yswallow/kidoairaku-swallowtail/assembly/kidoairaku-swallowtail-bom.csv

Designator | MPN | Qty | Link
D193,D206,D148,D155,D102,D251,D207,D188,D137,D149,D229,D104,D197,D196,D150,D153,D175,D120,D165,D240,D258,D228,D221,D220,D135,D145, D257,D158,D186,D112,D224,D237,D248,D231,D154,D164,D129,D210,D130,D254,D167,D126,D177,D195,D117,D199,D185,D255,D203,D171,D191,D121,D178, D162,D260,D140,D151,D204,D122,D134,D113,D249,D156,D245,D239,D230,D172,D179,D108,D173,D128,D253,D211,D132,D250,D190,D252,D198,D143,D213, D232,D222,D99,D139,D142,D182,D205,D114,D174,D136,D223,D159,D181,D168,D200,D227,D116,D110,D189,D244,D105,D187,D236,D226,D217,D209,D138, D111,D202,D163,D144,D214,D234,D157,D242,D233,D109,D212,D184,D166,D152,D256,D238,D146,D161,D247,D147,D180,D194,D103,D125,D192,D201,D118, D123,D119,D259,D219,D127,D243,D246,D160,D218,D183,D169,D133,D170,D215,D235,D176,D225,D106,D131,D97,D107,D241,D141,D124,D101,D115,D208, D216 | SK6803MINI-E | 162 | https://www.aliexpress.com/item/1005003636607308.html
D21,D71,D37,D24,D63,D83,D17,D68,D34,D6,D46,D48,D41,D14,D13,D5,D57,D72,D86,D18,D75,D78,D98,D73,D87,D74,D54,D51,D62,D65,D58,D31,D4,D61, D53,D67,D3,D12,D76,D42,D28,D47,D64,D36,D2,D45,D84,D82,D32,D35,D7,D23,D38,D52,D26,D25,D16,D56,D15,D43,D8,D1,D27 | 1N4148W | 63
U1 | Seeed Studio XIAO RP2040 | 1 | 102010428
