yswallow/kidoairaku-swallowtail/assembly/kidoairaku-swallowtail-additional-doc/component-align.jpg

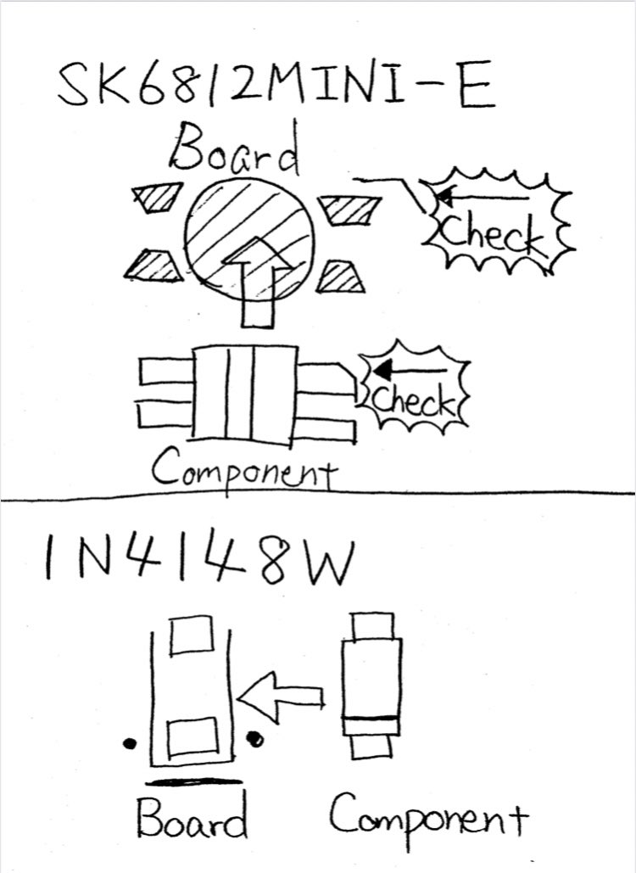
assembly/kidoairaku-swallowtail-additional-doc/component-align.jpg
