yswallow/kidoairaku-swallowtail/assembly/kidoairaku-swallowtail-additional-doc/kidoairaku-swallowtail-B_Fab.pdf

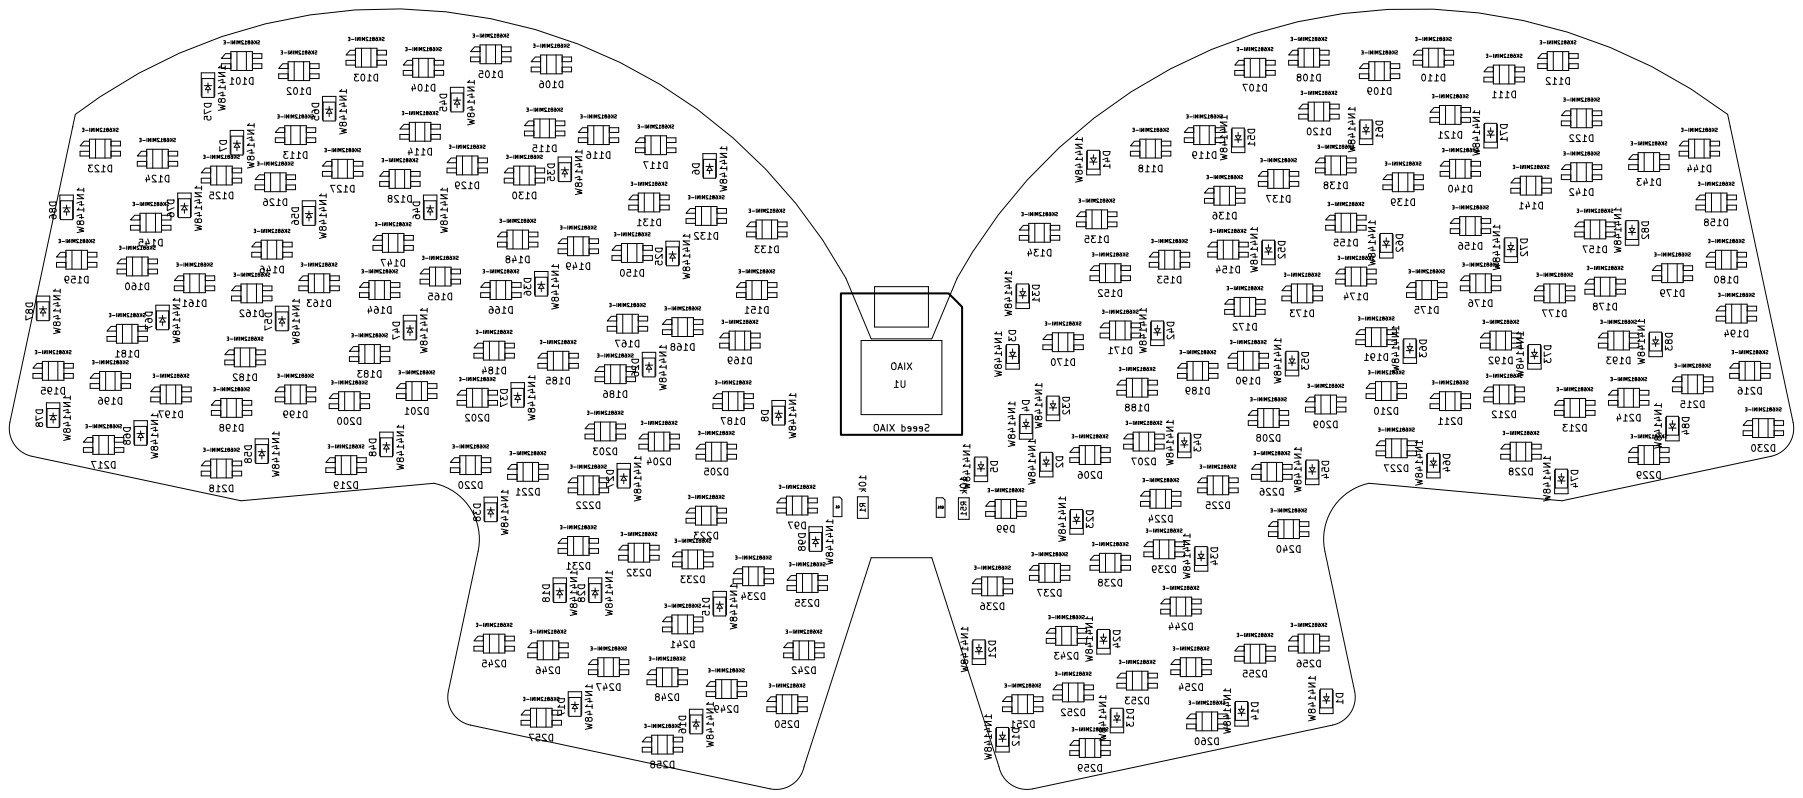
[picture p2: page 1]
