yswallow/kidoairaku-swallowtail/kidoairaku-swallowtail.kicad_pcb

## KiCad design kidoairaku-swallowtail.kicad_pcb (2023-01-27)

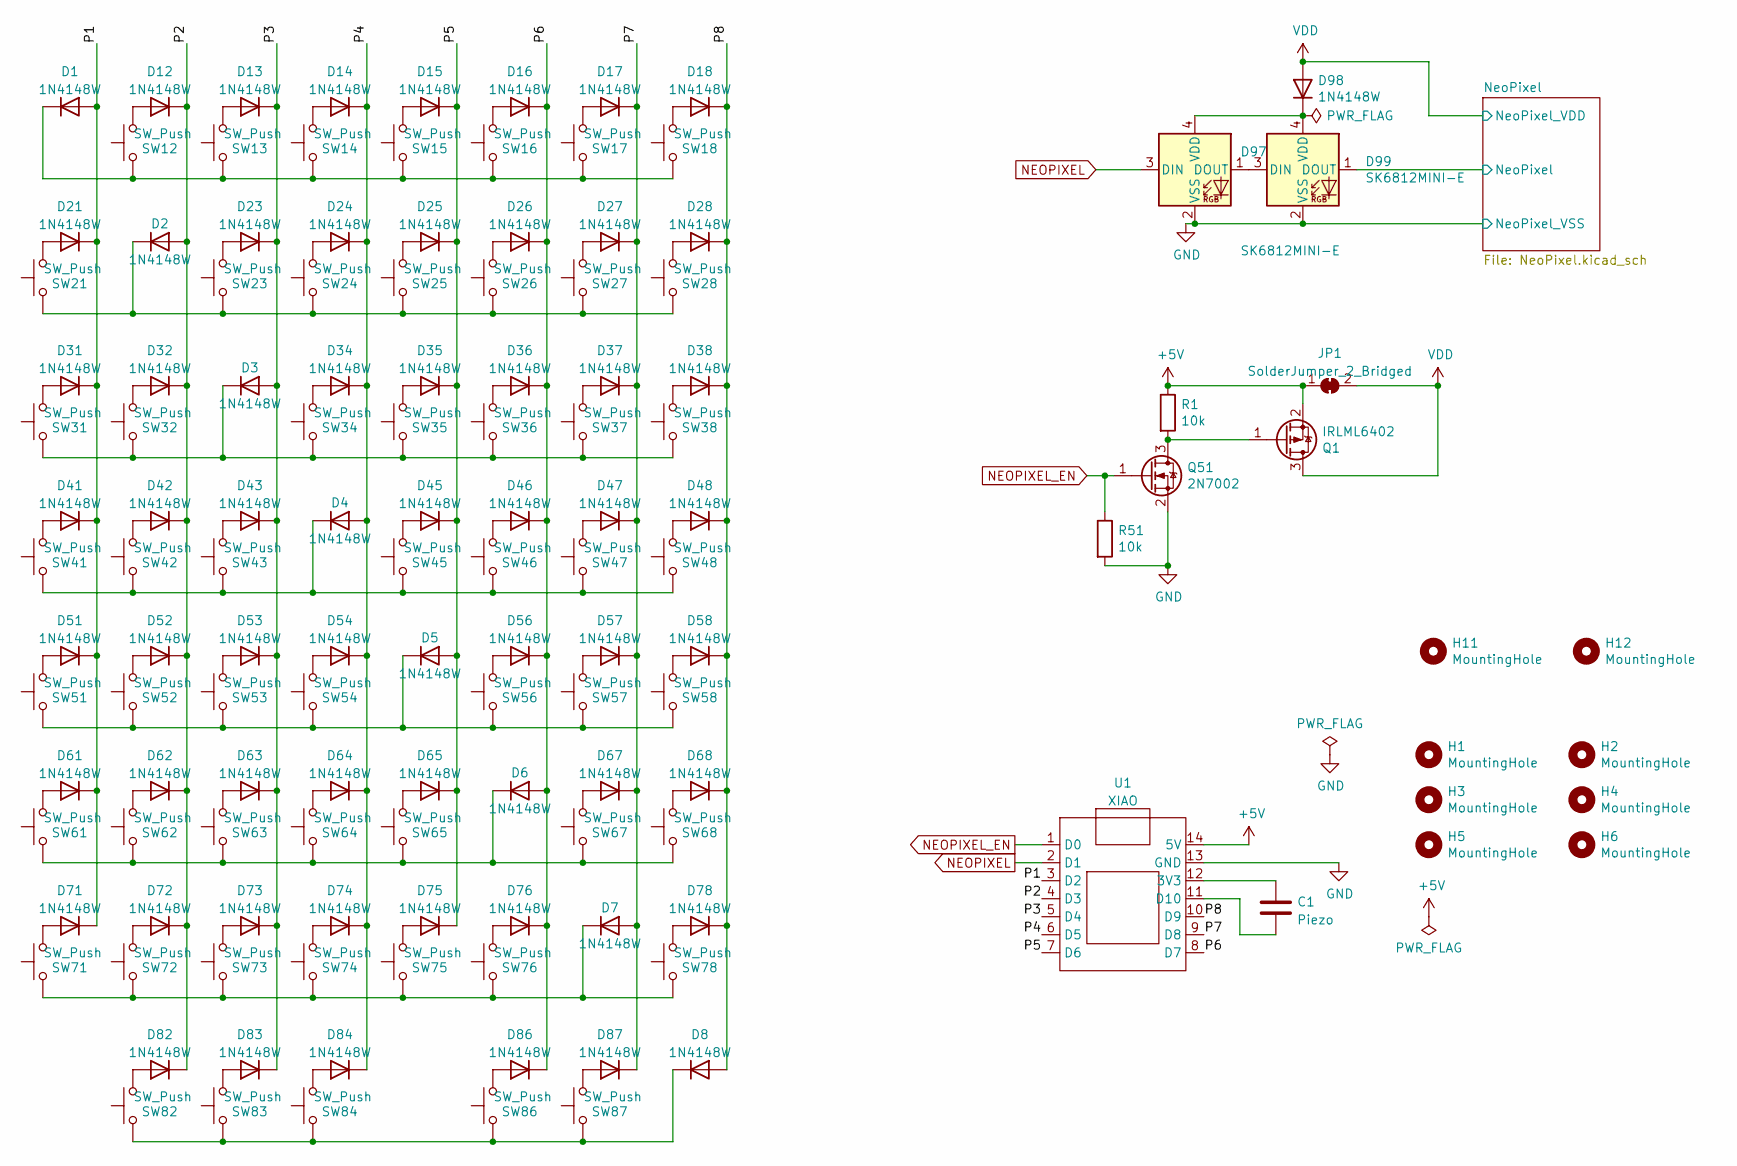
[picture p3: schematic kidoairaku-swallowtail.kicad_sch]

Parts:
C1: Piezo; C_Radial_D10.0mm_H12.5mm_P5.00mm
D1, D2, D3, D4, D5, D6, D7, D8, D12, D13, D14, D15, D16, D17, D18, D21, D23, D24, D25, D26, D27, D28, D31, D32, D34, D35, D36, D37, D38, D41, D42, D43, D45, D46, D47, D48, D51, D52, D53, D54, D56, D57, D58, D61, D62, D63, D64, D65, D67, D68, D71, D72, D73, D74, D75, D76, D78, D82, D83, D84, D86, D87, D98: 1N4148W; D_SOD-123
D97, D99: SK6812MINI-E; SK6812MINI-E_NoSilk-dril-PCBA
H1, H2, H3, H4, H5, H6, H11, H12: MountingHole; MountingHole_2.2mm_M2
JP1: SolderJumper_2_Bridged; SolderJumper-2_P1.3mm_Bridged_RoundedPad1.0x1.5mm
Q1: IRLML6402; SOT-23
Q51: 2N7002; SOT-23
R1, R51: 10k; R_1206_3216Metric_Pad1.30x1.75mm_HandSolder
SW12, SW13, SW14, SW15, SW16, SW17, SW18, SW21, SW23, SW24, SW25, SW26, SW27, SW28, SW31, SW32, SW34, SW35, SW36, SW37, SW38, SW41, SW42, SW43, SW45, SW46, SW47, SW48, SW51, SW52, SW53, SW54, SW56, SW57, SW58, SW61, SW62, SW63, SW64, SW65, SW67, SW68, SW71, SW72, SW73, SW74, SW75, SW76, SW78, SW82, SW83, SW84, SW86, SW87: SW_Push; SW_Choc_1U
U1: XIAO; Seeed XIAO SMD

Connections:
+5V: JP1.1 (A), Q1.2 (S), R1.1, U1.14 (5V)
/NeoPixel/NeoPixel: D99.1 (DOUT); also elsewhere on the board
/P1: D1.2 (A), D21.1 (K), D31.1 (K), D41.1 (K), D51.1 (K), D61.1 (K), D71.1 (K), U1.3 (D2)
/P2: D2.2 (A), D12.1 (K), D32.1 (K), D42.1 (K), D52.1 (K), D62.1 (K), D72.1 (K), D82.1 (K), U1.4 (D3)
/P3: D3.2 (A), D13.1 (K), D23.1 (K), D43.1 (K), D53.1 (K), D63.1 (K), D73.1 (K), D83.1 (K), U1.5 (D4)
/P4: D4.2 (A), D14.1 (K), D24.1 (K), D34.1 (K), D54.1 (K), D64.1 (K), D74.1 (K), D84.1 (K), U1.6 (D5)
/P5: D5.2 (A), D15.1 (K), D25.1 (K), D35.1 (K), D45.1 (K), D65.1 (K), D75.1 (K), U1.7 (D6)
/P6: D6.2 (A), D16.1 (K), D26.1 (K), D36.1 (K), D46.1 (K), D56.1 (K), D76.1 (K), D86.1 (K), U1.8 (D7)
/P7: D7.2 (A), D17.1 (K), D27.1 (K), D37.1 (K), D47.1 (K), D57.1 (K), D67.1 (K), D87.1 (K), U1.9 (D8)
/P8: D8.2 (A), D18.1 (K), D28.1 (K), D38.1 (K), D48.1 (K), D58.1 (K), D68.1 (K), D78.1 (K), U1.10 (D9)
GND: D97.2 (VSS), D99.2 (VSS), Q51.2 (S), R51.2, U1.13 (GND); also elsewhere on the board
NEOPIXEL: D97.3 (DIN), U1.2 (D1)
NEOPIXEL_EN: Q51.1 (G), R51.1, U1.1 (D0)
unnamed: D1.1 (K), SW12.2, SW13.2, SW14.2, SW15.2, SW16.2, SW17.2, SW18.2
unnamed: D2.1 (K), SW21.2, SW23.2, SW24.2, SW25.2, SW26.2, SW27.2, SW28.2
unnamed: D3.1 (K), SW31.2, SW32.2, SW34.2, SW35.2, SW36.2, SW37.2, SW38.2
unnamed: D4.1 (K), SW41.2, SW42.2, SW43.2, SW45.2, SW46.2, SW47.2, SW48.2
unnamed: D5.1 (K), SW51.2, SW52.2, SW53.2, SW54.2, SW56.2, SW57.2, SW58.2
unnamed: D6.1 (K), SW61.2, SW62.2, SW63.2, SW64.2, SW65.2, SW67.2, SW68.2
unnamed: D7.1 (K), SW71.2, SW72.2, SW73.2, SW74.2, SW75.2, SW76.2, SW78.2
unnamed: D8.1 (K), SW82.2, SW83.2, SW84.2, SW86.2, SW87.2
unnamed: D12.2 (A), SW12.1
unnamed: D13.2 (A), SW13.1
unnamed: D14.2 (A), SW14.1
unnamed: D15.2 (A), SW15.1
unnamed: D16.2 (A), SW16.1
unnamed: D17.2 (A), SW17.1
unnamed: D18.2 (A), SW18.1
unnamed: D21.2 (A), SW21.1
unnamed: D23.2 (A), SW23.1
unnamed: D24.2 (A), SW24.1
unnamed: D25.2 (A), SW25.1
unnamed: D26.2 (A), SW26.1
unnamed: D27.2 (A), SW27.1
unnamed: D28.2 (A), SW28.1
unnamed: D31.2 (A), SW31.1
unnamed: D32.2 (A), SW32.1
unnamed: D34.2 (A), SW34.1
unnamed: D35.2 (A), SW35.1
unnamed: D36.2 (A), SW36.1
unnamed: D37.2 (A), SW37.1
unnamed: D38.2 (A), SW38.1
unnamed: D41.2 (A), SW41.1
unnamed: D42.2 (A), SW42.1
unnamed: D43.2 (A), SW43.1
unnamed: D45.2 (A), SW45.1
unnamed: D46.2 (A), SW46.1
unnamed: D47.2 (A), SW47.1
unnamed: D48.2 (A), SW48.1
unnamed: D51.2 (A), SW51.1
unnamed: D52.2 (A), SW52.1
unnamed: D53.2 (A), SW53.1
unnamed: D54.2 (A), SW54.1
unnamed: D56.2 (A), SW56.1
unnamed: D57.2 (A), SW57.1
unnamed: D58.2 (A), SW58.1
unnamed: D61.2 (A), SW61.1
unnamed: D62.2 (A), SW62.1
unnamed: D63.2 (A), SW63.1
unnamed: D64.2 (A), SW64.1
unnamed: D65.2 (A), SW65.1
unnamed: D67.2 (A), SW67.1
unnamed: D68.2 (A), SW68.1
unnamed: D71.2 (A), SW71.1
unnamed: D72.2 (A), SW72.1
unnamed: D73.2 (A), SW73.1
unnamed: D74.2 (A), SW74.1
unnamed: D75.2 (A), SW75.1
unnamed: D76.2 (A), SW76.1
unnamed: D78.2 (A), SW78.1
unnamed: D82.2 (A), SW82.1
unnamed: D83.2 (A), SW83.1
unnamed: D84.2 (A), SW84.1
unnamed: D86.2 (A), SW86.1
unnamed: D87.2 (A), SW87.1
unnamed: D97.1 (DOUT), D99.3 (DIN)
unnamed: D97.4 (VDD), D98.1 (K), D99.4 (VDD)
unnamed: Q1.1 (G), Q51.3 (D), R1.2
unnamed: C1.2, U1.11 (D10)
unnamed: C1.1, U1.12 (3V3)
VDD: D98.2 (A), JP1.2 (B), Q1.3 (D); also elsewhere on the board

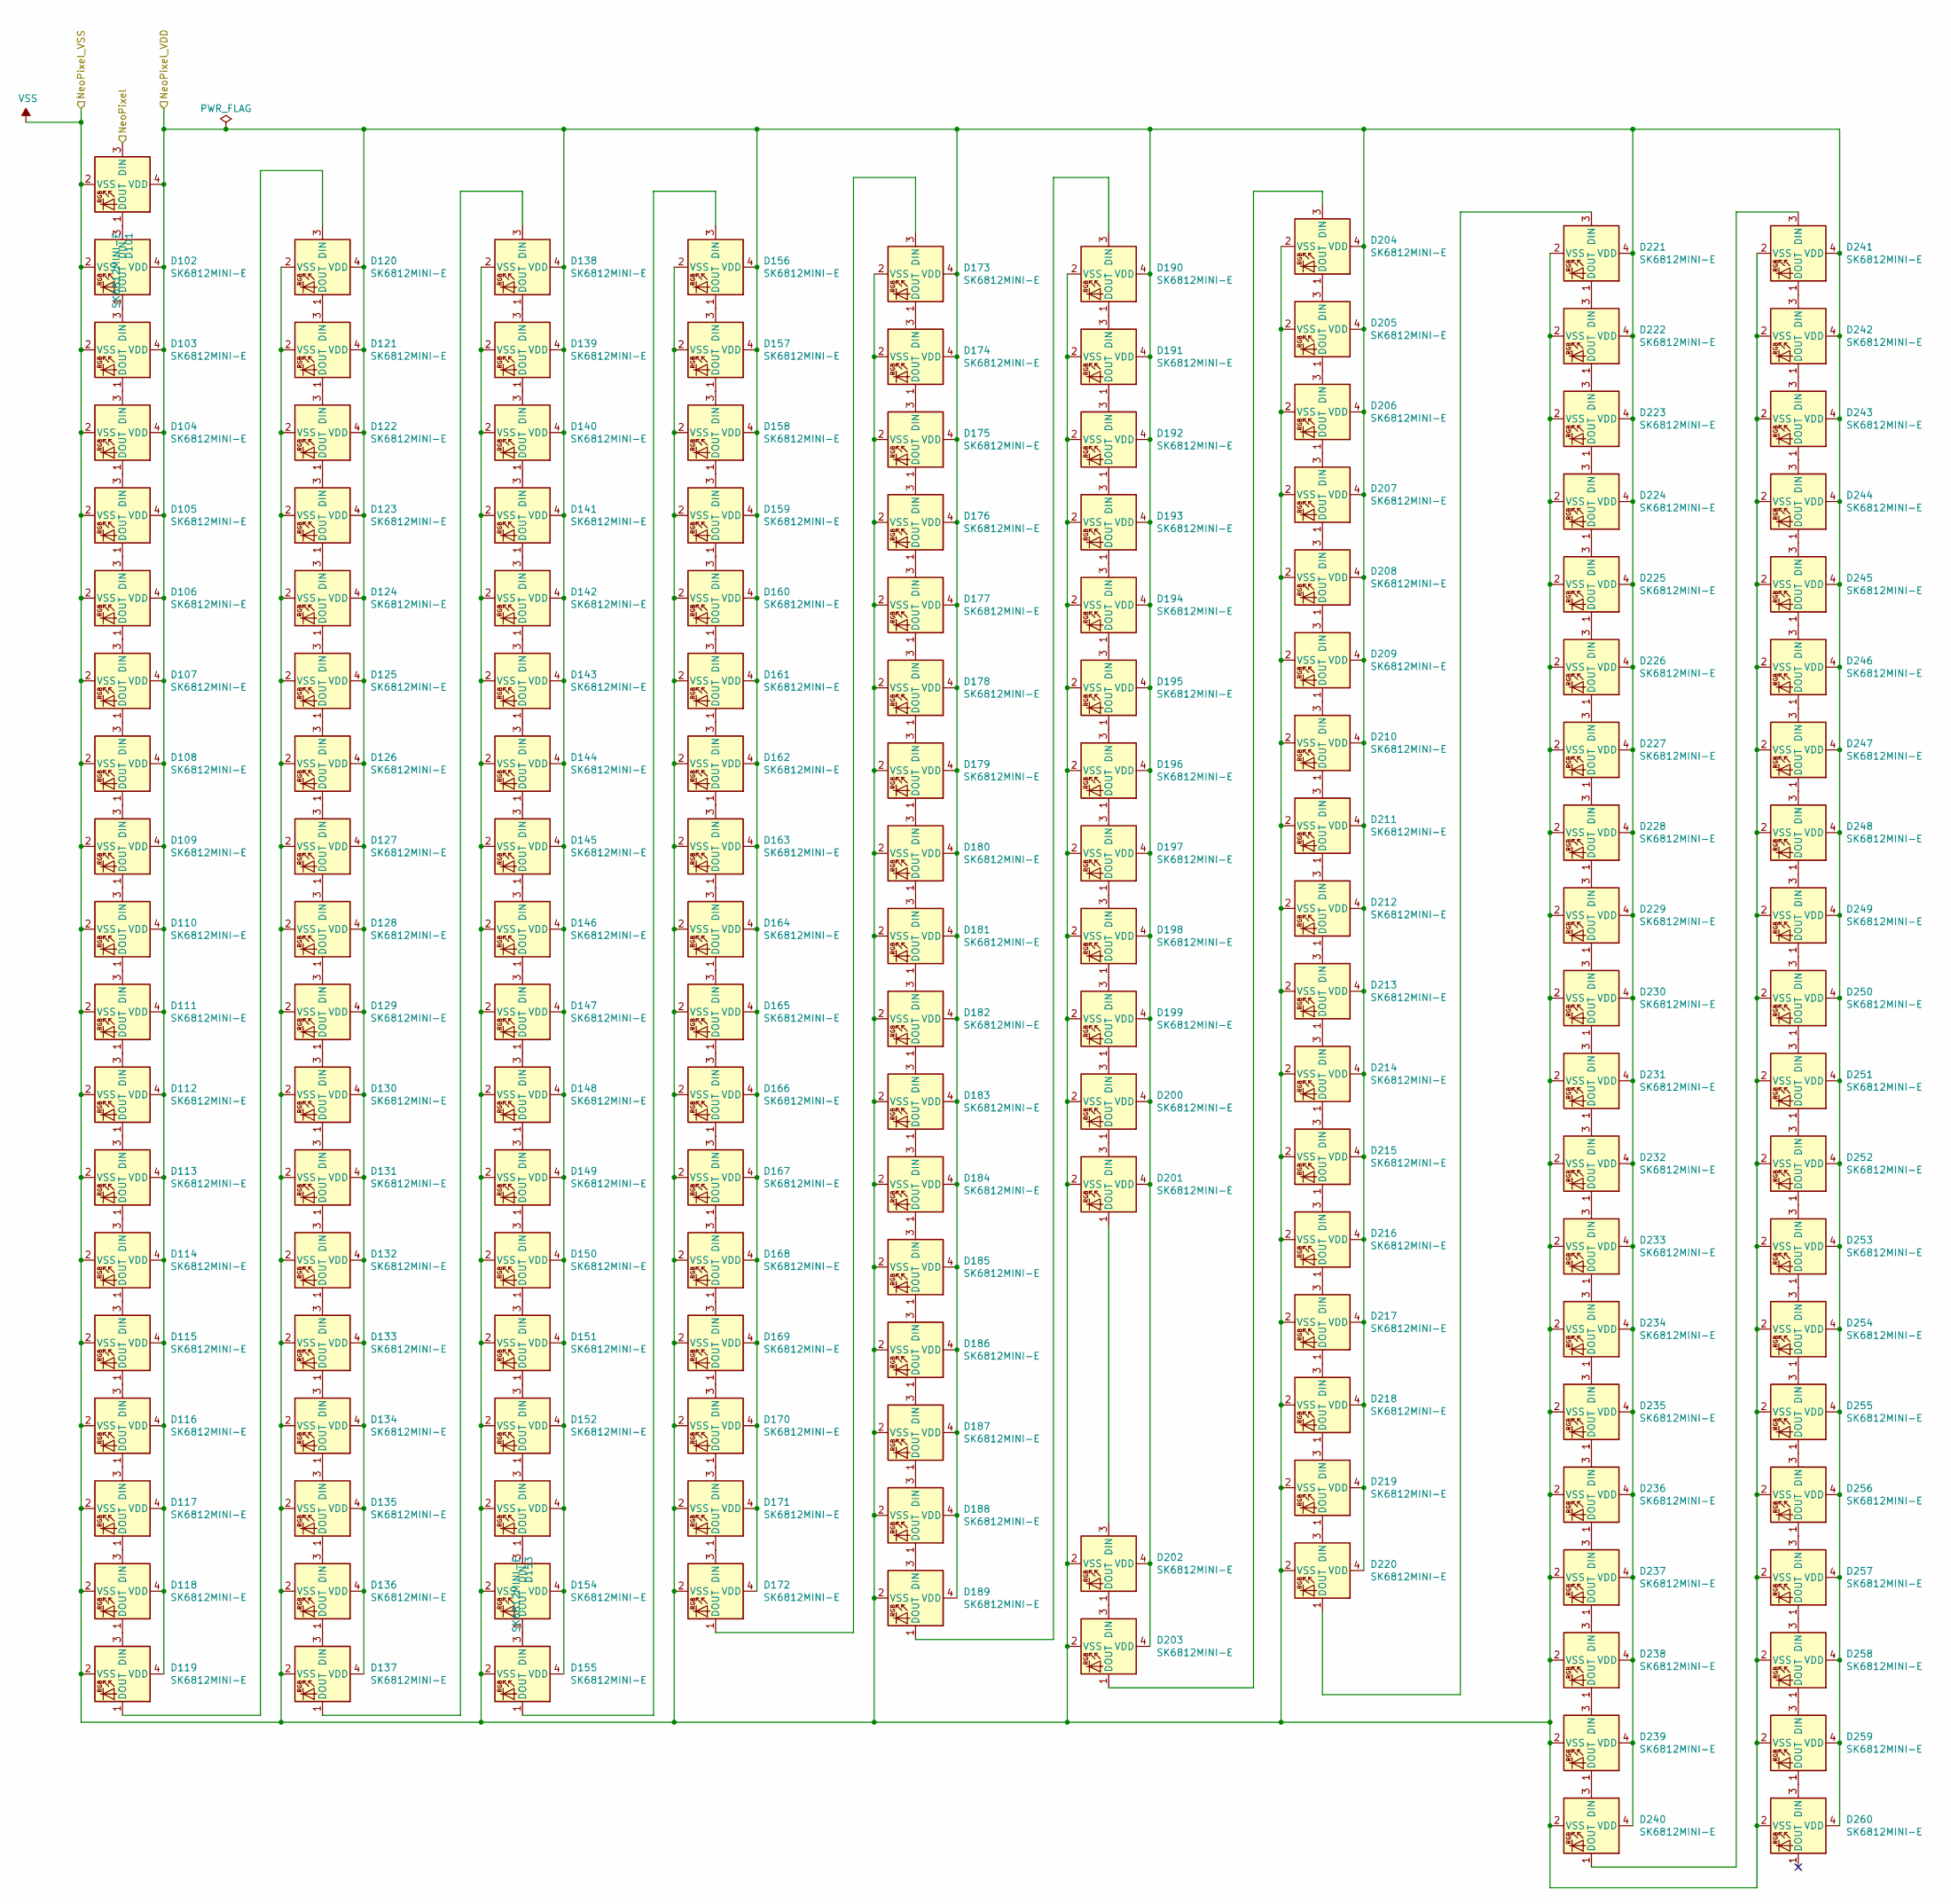
[picture p4: schematic NeoPixel.kicad_sch]

Parts:
D101, D102, D103, D104, D105, D106, D107, D108, D109, D110, D111, D112, D113, D114, D115, D116, D117, D118, D119, D120, D121, D122, D123, D124, D125, D126, D127, D128, D129, D130, D131, D132, D133, D134, D135, D136, D137, D138, D139, D140, D141, D142, D143, D144, D145, D146, D147, D148, D149, D150, D151, D152, D153, D154, D155, D156, D157, D158, D159, D160, D161, D162, D163, D164, D165, D166, D167, D168, D169, D170, D171, D172, D173, D174, D175, D176, D177, D178, D179, D180, D181, D182, D183, D184, D185, D186, D187, D188, D189, D190, D191, D192, D193, D194, D195, D196, D197, D198, D199, D200, D201, D202, D203, D204, D205, D206, D207, D208, D209, D210, D211, D212, D213, D214, D215, D216, D217, D218, D219, D220, D221, D222, D223, D224, D225, D226, D227, D228, D229, D230, D231, D232, D233, D234, D235, D236, D237, D238, D239, D240, D241, D242, D243, D244, D245, D246, D247, D248, D249, D250, D251, D252, D253, D254, D255, D256, D257, D258, D259, D260: SK6812MINI-E; SK6812MINI-E_NoSilk-dril-PCBA

Connections:
/NeoPixel/NeoPixel: D101.3 (DIN); also elsewhere on the board
GND: D101.2 (VSS), D102.2 (VSS), D103.2 (VSS), D104.2 (VSS), D105.2 (VSS), D106.2 (VSS), D107.2 (VSS), D108.2 (VSS), D109.2 (VSS), D110.2 (VSS), D111.2 (VSS), D112.2 (VSS), D113.2 (VSS), D114.2 (VSS), D115.2 (VSS), D116.2 (VSS), D117.2 (VSS), D118.2 (VSS), D119.2 (VSS), D120.2 (VSS), D121.2 (VSS), D122.2 (VSS), D123.2 (VSS), D124.2 (VSS), D125.2 (VSS), D126.2 (VSS), D127.2 (VSS), D128.2 (VSS), D129.2 (VSS), D130.2 (VSS), D131.2 (VSS), D132.2 (VSS), D133.2 (VSS), D134.2 (VSS), D135.2 (VSS), D136.2 (VSS), D137.2 (VSS), D138.2 (VSS), D139.2 (VSS), D140.2 (VSS), D141.2 (VSS), D142.2 (VSS), D143.2 (VSS), D144.2 (VSS), D145.2 (VSS), D146.2 (VSS), D147.2 (VSS), D148.2 (VSS), D149.2 (VSS), D150.2 (VSS), D151.2 (VSS), D152.2 (VSS), D153.2 (VSS), D154.2 (VSS), D155.2 (VSS), D156.2 (VSS), D157.2 (VSS), D158.2 (VSS), D159.2 (VSS), D160.2 (VSS), D161.2 (VSS), D162.2 (VSS), D163.2 (VSS), D164.2 (VSS), D165.2 (VSS), D166.2 (VSS), D167.2 (VSS), D168.2 (VSS), D169.2 (VSS), D170.2 (VSS), D171.2 (VSS), D172.2 (VSS), D173.2 (VSS), D174.2 (VSS), D175.2 (VSS), D176.2 (VSS), D177.2 (VSS), D178.2 (VSS), D179.2 (VSS), D180.2 (VSS), D181.2 (VSS), D182.2 (VSS), D183.2 (VSS), D184.2 (VSS), D185.2 (VSS), D186.2 (VSS), D187.2 (VSS), D188.2 (VSS), D189.2 (VSS), D190.2 (VSS), D191.2 (VSS), D192.2 (VSS), D193.2 (VSS), D194.2 (VSS), D195.2 (VSS), D196.2 (VSS), D197.2 (VSS), D198.2 (VSS), D199.2 (VSS), D200.2 (VSS), D201.2 (VSS), D202.2 (VSS), D203.2 (VSS), D204.2 (VSS), D205.2 (VSS), D206.2 (VSS), D207.2 (VSS), D208.2 (VSS), D209.2 (VSS), D210.2 (VSS), D211.2 (VSS), D212.2 (VSS), D213.2 (VSS), D214.2 (VSS), D215.2 (VSS), D216.2 (VSS), D217.2 (VSS), D218.2 (VSS), D219.2 (VSS), D220.2 (VSS), D221.2 (VSS), D222.2 (VSS), D223.2 (VSS), D224.2 (VSS), D225.2 (VSS), D226.2 (VSS), D227.2 (VSS), D228.2 (VSS), D229.2 (VSS), D230.2 (VSS), D231.2 (VSS), D232.2 (VSS), D233.2 (VSS), D234.2 (VSS), D235.2 (VSS), D236.2 (VSS), D237.2 (VSS), D238.2 (VSS), D239.2 (VSS), D240.2 (VSS), D241.2 (VSS), D242.2 (VSS), D243.2 (VSS), D244.2 (VSS), D245.2 (VSS), D246.2 (VSS), D247.2 (VSS), D248.2 (VSS), D249.2 (VSS), D250.2 (VSS), D251.2 (VSS), D252.2 (VSS), D253.2 (VSS), D254.2 (VSS), D255.2 (VSS), D256.2 (VSS), D257.2 (VSS), D258.2 (VSS), D259.2 (VSS), D260.2 (VSS); also elsewhere on the board
unnamed: D101.1 (DOUT), D102.3 (DIN)
unnamed: D102.1 (DOUT), D103.3 (DIN)
unnamed: D103.1 (DOUT), D104.3 (DIN)
unnamed: D104.1 (DOUT), D105.3 (DIN)
unnamed: D105.1 (DOUT), D106.3 (DIN)
unnamed: D106.1 (DOUT), D107.3 (DIN)
unnamed: D107.1 (DOUT), D108.3 (DIN)
unnamed: D108.1 (DOUT), D109.3 (DIN)
unnamed: D109.1 (DOUT), D110.3 (DIN)
unnamed: D110.1 (DOUT), D111.3 (DIN)
unnamed: D111.1 (DOUT), D112.3 (DIN)
unnamed: D112.1 (DOUT), D113.3 (DIN)
unnamed: D113.1 (DOUT), D114.3 (DIN)
unnamed: D114.1 (DOUT), D115.3 (DIN)
unnamed: D115.1 (DOUT), D116.3 (DIN)
unnamed: D116.1 (DOUT), D117.3 (DIN)
unnamed: D117.1 (DOUT), D118.3 (DIN)
unnamed: D118.1 (DOUT), D119.3 (DIN)
unnamed: D119.1 (DOUT), D120.3 (DIN)
unnamed: D120.1 (DOUT), D121.3 (DIN)
unnamed: D121.1 (DOUT), D122.3 (DIN)
unnamed: D122.1 (DOUT), D123.3 (DIN)
unnamed: D123.1 (DOUT), D124.3 (DIN)
unnamed: D124.1 (DOUT), D125.3 (DIN)
unnamed: D125.1 (DOUT), D126.3 (DIN)
unnamed: D126.1 (DOUT), D127.3 (DIN)
unnamed: D127.1 (DOUT), D128.3 (DIN)
unnamed: D128.1 (DOUT), D129.3 (DIN)
unnamed: D129.1 (DOUT), D130.3 (DIN)
unnamed: D130.1 (DOUT), D131.3 (DIN)
unnamed: D131.1 (DOUT), D132.3 (DIN)
unnamed: D132.1 (DOUT), D133.3 (DIN)
unnamed: D133.1 (DOUT), D134.3 (DIN)
unnamed: D134.1 (DOUT), D135.3 (DIN)
unnamed: D135.1 (DOUT), D136.3 (DIN)
unnamed: D136.1 (DOUT), D137.3 (DIN)
unnamed: D137.1 (DOUT), D138.3 (DIN)
unnamed: D138.1 (DOUT), D139.3 (DIN)
unnamed: D139.1 (DOUT), D140.3 (DIN)
unnamed: D140.1 (DOUT), D141.3 (DIN)
unnamed: D141.1 (DOUT), D142.3 (DIN)
unnamed: D142.1 (DOUT), D143.3 (DIN)
unnamed: D143.1 (DOUT), D144.3 (DIN)
unnamed: D144.1 (DOUT), D145.3 (DIN)
unnamed: D145.1 (DOUT), D146.3 (DIN)
unnamed: D146.1 (DOUT), D147.3 (DIN)
unnamed: D147.1 (DOUT), D148.3 (DIN)
unnamed: D148.1 (DOUT), D149.3 (DIN)
unnamed: D149.1 (DOUT), D150.3 (DIN)
unnamed: D150.1 (DOUT), D151.3 (DIN)
unnamed: D151.1 (DOUT), D152.3 (DIN)
unnamed: D152.1 (DOUT), D153.3 (DIN)
unnamed: D153.1 (DOUT), D154.3 (DIN)
unnamed: D154.1 (DOUT), D155.3 (DIN)
unnamed: D155.1 (DOUT), D156.3 (DIN)
unnamed: D156.1 (DOUT), D157.3 (DIN)
unnamed: D157.1 (DOUT), D158.3 (DIN)
unnamed: D158.1 (DOUT), D159.3 (DIN)
unnamed: D159.1 (DOUT), D160.3 (DIN)
unnamed: D160.1 (DOUT), D161.3 (DIN)
unnamed: D161.1 (DOUT), D162.3 (DIN)
unnamed: D162.1 (DOUT), D163.3 (DIN)
unnamed: D163.1 (DOUT), D164.3 (DIN)
unnamed: D164.1 (DOUT), D165.3 (DIN)
unnamed: D165.1 (DOUT), D166.3 (DIN)
unnamed: D166.1 (DOUT), D167.3 (DIN)
unnamed: D167.1 (DOUT), D168.3 (DIN)
unnamed: D168.1 (DOUT), D169.3 (DIN)
unnamed: D169.1 (DOUT), D170.3 (DIN)
unnamed: D170.1 (DOUT), D171.3 (DIN)
unnamed: D171.1 (DOUT), D172.3 (DIN)
unnamed: D172.1 (DOUT), D173.3 (DIN)
unnamed: D173.1 (DOUT), D174.3 (DIN)
unnamed: D174.1 (DOUT), D175.3 (DIN)
unnamed: D175.1 (DOUT), D176.3 (DIN)
unnamed: D176.1 (DOUT), D177.3 (DIN)
unnamed: D177.1 (DOUT), D178.3 (DIN)
unnamed: D178.1 (DOUT), D179.3 (DIN)
unnamed: D179.1 (DOUT), D180.3 (DIN)
unnamed: D180.1 (DOUT), D181.3 (DIN)
unnamed: D181.1 (DOUT), D182.3 (DIN)
unnamed: D182.1 (DOUT), D183.3 (DIN)
unnamed: D183.1 (DOUT), D184.3 (DIN)
unnamed: D184.1 (DOUT), D185.3 (DIN)
unnamed: D185.1 (DOUT), D186.3 (DIN)
unnamed: D186.1 (DOUT), D187.3 (DIN)
unnamed: D187.1 (DOUT), D188.3 (DIN)
unnamed: D188.1 (DOUT), D189.3 (DIN)
unnamed: D189.1 (DOUT), D190.3 (DIN)
unnamed: D190.1 (DOUT), D191.3 (DIN)
unnamed: D191.1 (DOUT), D192.3 (DIN)
unnamed: D192.1 (DOUT), D193.3 (DIN)
unnamed: D193.1 (DOUT), D194.3 (DIN)
unnamed: D194.1 (DOUT), D195.3 (DIN)
unnamed: D195.1 (DOUT), D196.3 (DIN)
unnamed: D196.1 (DOUT), D197.3 (DIN)
unnamed: D197.1 (DOUT), D198.3 (DIN)
unnamed: D198.1 (DOUT), D199.3 (DIN)
unnamed: D199.1 (DOUT), D200.3 (DIN)
unnamed: D200.1 (DOUT), D201.3 (DIN)
unnamed: D201.1 (DOUT), D202.3 (DIN)
unnamed: D202.1 (DOUT), D203.3 (DIN)
unnamed: D203.1 (DOUT), D204.3 (DIN)
unnamed: D204.1 (DOUT), D205.3 (DIN)
unnamed: D205.1 (DOUT), D206.3 (DIN)
unnamed: D206.1 (DOUT), D207.3 (DIN)
unnamed: D207.1 (DOUT), D208.3 (DIN)
unnamed: D208.1 (DOUT), D209.3 (DIN)
unnamed: D209.1 (DOUT), D210.3 (DIN)
unnamed: D210.1 (DOUT), D211.3 (DIN)
unnamed: D211.1 (DOUT), D212.3 (DIN)
unnamed: D212.1 (DOUT), D213.3 (DIN)
unnamed: D213.1 (DOUT), D214.3 (DIN)
unnamed: D214.1 (DOUT), D215.3 (DIN)
unnamed: D215.1 (DOUT), D216.3 (DIN)
unnamed: D216.1 (DOUT), D217.3 (DIN)
unnamed: D217.1 (DOUT), D218.3 (DIN)
unnamed: D218.1 (DOUT), D219.3 (DIN)
unnamed: D219.1 (DOUT), D220.3 (DIN)
unnamed: D220.1 (DOUT), D221.3 (DIN)
unnamed: D221.1 (DOUT), D222.3 (DIN)
unnamed: D222.1 (DOUT), D223.3 (DIN)
unnamed: D223.1 (DOUT), D224.3 (DIN)
unnamed: D224.1 (DOUT), D225.3 (DIN)
unnamed: D225.1 (DOUT), D226.3 (DIN)
unnamed: D226.1 (DOUT), D227.3 (DIN)
unnamed: D227.1 (DOUT), D228.3 (DIN)
unnamed: D228.1 (DOUT), D229.3 (DIN)
unnamed: D229.1 (DOUT), D230.3 (DIN)
unnamed: D230.1 (DOUT), D231.3 (DIN)
unnamed: D231.1 (DOUT), D232.3 (DIN)
unnamed: D232.1 (DOUT), D233.3 (DIN)
unnamed: D233.1 (DOUT), D234.3 (DIN)
unnamed: D234.1 (DOUT), D235.3 (DIN)
unnamed: D235.1 (DOUT), D236.3 (DIN)
unnamed: D236.1 (DOUT), D237.3 (DIN)
unnamed: D237.1 (DOUT), D238.3 (DIN)
unnamed: D238.1 (DOUT), D239.3 (DIN)
unnamed: D239.1 (DOUT), D240.3 (DIN)
unnamed: D240.1 (DOUT), D241.3 (DIN)
unnamed: D241.1 (DOUT), D242.3 (DIN)
unnamed: D242.1 (DOUT), D243.3 (DIN)
unnamed: D243.1 (DOUT), D244.3 (DIN)
unnamed: D244.1 (DOUT), D245.3 (DIN)
unnamed: D245.1 (DOUT), D246.3 (DIN)
unnamed: D246.1 (DOUT), D247.3 (DIN)
unnamed: D247.1 (DOUT), D248.3 (DIN)
unnamed: D248.1 (DOUT), D249.3 (DIN)
unnamed: D249.1 (DOUT), D250.3 (DIN)
unnamed: D250.1 (DOUT), D251.3 (DIN)
unnamed: D251.1 (DOUT), D252.3 (DIN)
unnamed: D252.1 (DOUT), D253.3 (DIN)
unnamed: D253.1 (DOUT), D254.3 (DIN)
unnamed: D254.1 (DOUT), D255.3 (DIN)
unnamed: D255.1 (DOUT), D256.3 (DIN)
unnamed: D256.1 (DOUT), D257.3 (DIN)
unnamed: D257.1 (DOUT), D258.3 (DIN)
unnamed: D258.1 (DOUT), D259.3 (DIN)
unnamed: D259.1 (DOUT), D260.3 (DIN)
VDD: D101.4 (VDD), D102.4 (VDD), D103.4 (VDD), D104.4 (VDD), D105.4 (VDD), D106.4 (VDD), D107.4 (VDD), D108.4 (VDD), D109.4 (VDD), D110.4 (VDD), D111.4 (VDD), D112.4 (VDD), D113.4 (VDD), D114.4 (VDD), D115.4 (VDD), D116.4 (VDD), D117.4 (VDD), D118.4 (VDD), D119.4 (VDD), D120.4 (VDD), D121.4 (VDD), D122.4 (VDD), D123.4 (VDD), D124.4 (VDD), D125.4 (VDD), D126.4 (VDD), D127.4 (VDD), D128.4 (VDD), D129.4 (VDD), D130.4 (VDD), D131.4 (VDD), D132.4 (VDD), D133.4 (VDD), D134.4 (VDD), D135.4 (VDD), D136.4 (VDD), D137.4 (VDD), D138.4 (VDD), D139.4 (VDD), D140.4 (VDD), D141.4 (VDD), D142.4 (VDD), D143.4 (VDD), D144.4 (VDD), D145.4 (VDD), D146.4 (VDD), D147.4 (VDD), D148.4 (VDD), D149.4 (VDD), D150.4 (VDD), D151.4 (VDD), D152.4 (VDD), D153.4 (VDD), D154.4 (VDD), D155.4 (VDD), D156.4 (VDD), D157.4 (VDD), D158.4 (VDD), D159.4 (VDD), D160.4 (VDD), D161.4 (VDD), D162.4 (VDD), D163.4 (VDD), D164.4 (VDD), D165.4 (VDD), D166.4 (VDD), D167.4 (VDD), D168.4 (VDD), D169.4 (VDD), D170.4 (VDD), D171.4 (VDD), D172.4 (VDD), D173.4 (VDD), D174.4 (VDD), D175.4 (VDD), D176.4 (VDD), D177.4 (VDD), D178.4 (VDD), D179.4 (VDD), D180.4 (VDD), D181.4 (VDD), D182.4 (VDD), D183.4 (VDD), D184.4 (VDD), D185.4 (VDD), D186.4 (VDD), D187.4 (VDD), D188.4 (VDD), D189.4 (VDD), D190.4 (VDD), D191.4 (VDD), D192.4 (VDD), D193.4 (VDD), D194.4 (VDD), D195.4 (VDD), D196.4 (VDD), D197.4 (VDD), D198.4 (VDD), D199.4 (VDD), D200.4 (VDD), D201.4 (VDD), D202.4 (VDD), D203.4 (VDD), D204.4 (VDD), D205.4 (VDD), D206.4 (VDD), D207.4 (VDD), D208.4 (VDD), D209.4 (VDD), D210.4 (VDD), D211.4 (VDD), D212.4 (VDD), D213.4 (VDD), D214.4 (VDD), D215.4 (VDD), D216.4 (VDD), D217.4 (VDD), D218.4 (VDD), D219.4 (VDD), D220.4 (VDD), D221.4 (VDD), D222.4 (VDD), D223.4 (VDD), D224.4 (VDD), D225.4 (VDD), D226.4 (VDD), D227.4 (VDD), D228.4 (VDD), D229.4 (VDD), D230.4 (VDD), D231.4 (VDD), D232.4 (VDD), D233.4 (VDD), D234.4 (VDD), D235.4 (VDD), D236.4 (VDD), D237.4 (VDD), D238.4 (VDD), D239.4 (VDD), D240.4 (VDD), D241.4 (VDD), D242.4 (VDD), D243.4 (VDD), D244.4 (VDD), D245.4 (VDD), D246.4 (VDD), D247.4 (VDD), D248.4 (VDD), D249.4 (VDD), D250.4 (VDD), D251.4 (VDD), D252.4 (VDD), D253.4 (VDD), D254.4 (VDD), D255.4 (VDD), D256.4 (VDD), D257.4 (VDD), D258.4 (VDD), D259.4 (VDD), D260.4 (VDD); also elsewhere on the board

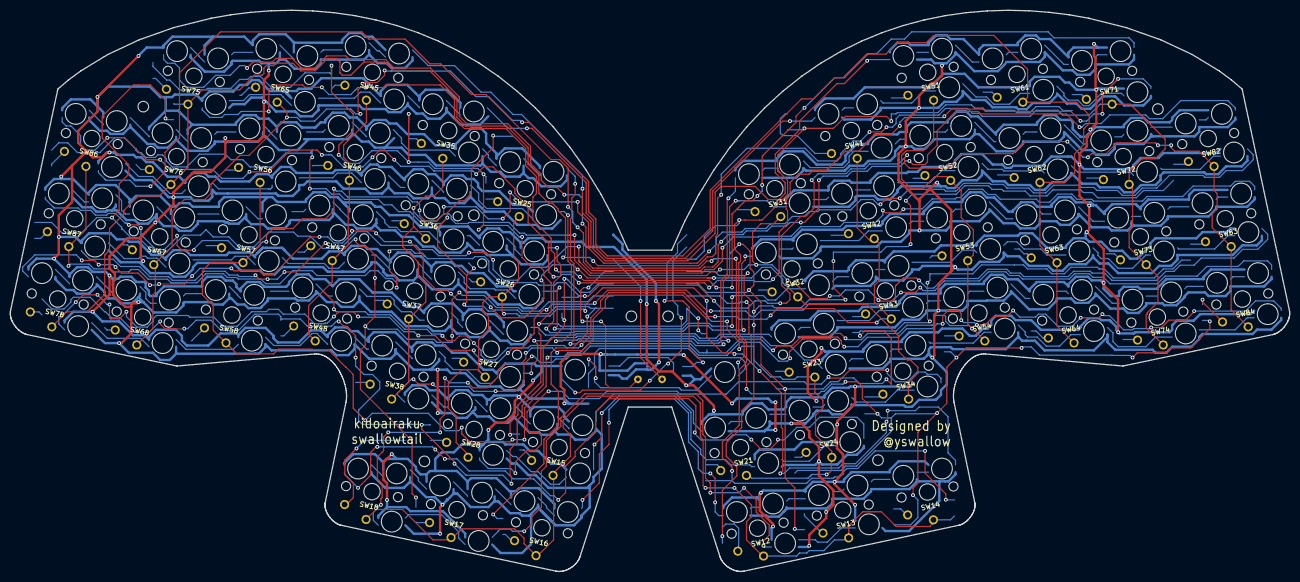
[picture p5: board kidoairaku-swallowtail.kicad_pcb from above]

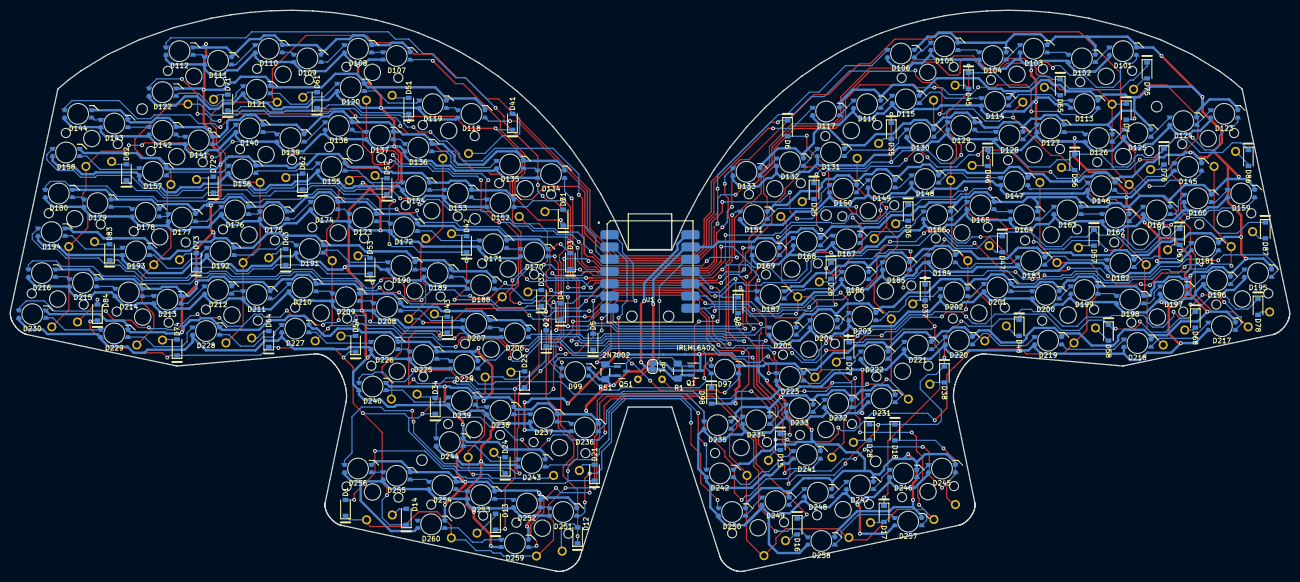
[picture p6: board kidoairaku-swallowtail.kicad_pcb from below]

Board: 2 copper layers, 265.1 x 116.3 mm, 294 parts (231 on the bottom side), 240 nets.
